Steffl98/autobalanced_photodetector/kicad/Autobalanced_Photodetector/Datasheets/STO46S-Documents/STO46S-Step.step

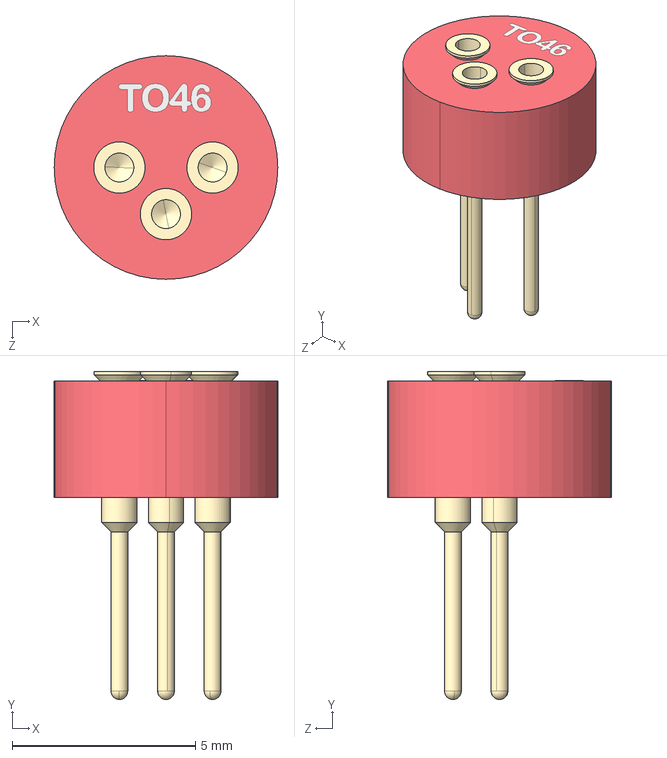
[picture p1: CAD file, 2026-11-10]
kicad/Autobalanced_Photodetector/Datasheets/STO46S-Documents/STO46S-Step.step
6.10 x 8.94 x 6.10 mm
STO46-PC1
2100-9553-0-15-15-21-27-04-0_default x 3
