Steffl98/autobalanced_photodetector/kicad/Autobalanced_Photodetector/Datasheets/STO46S-Documents/STO46S-CAD-DXF.dxf

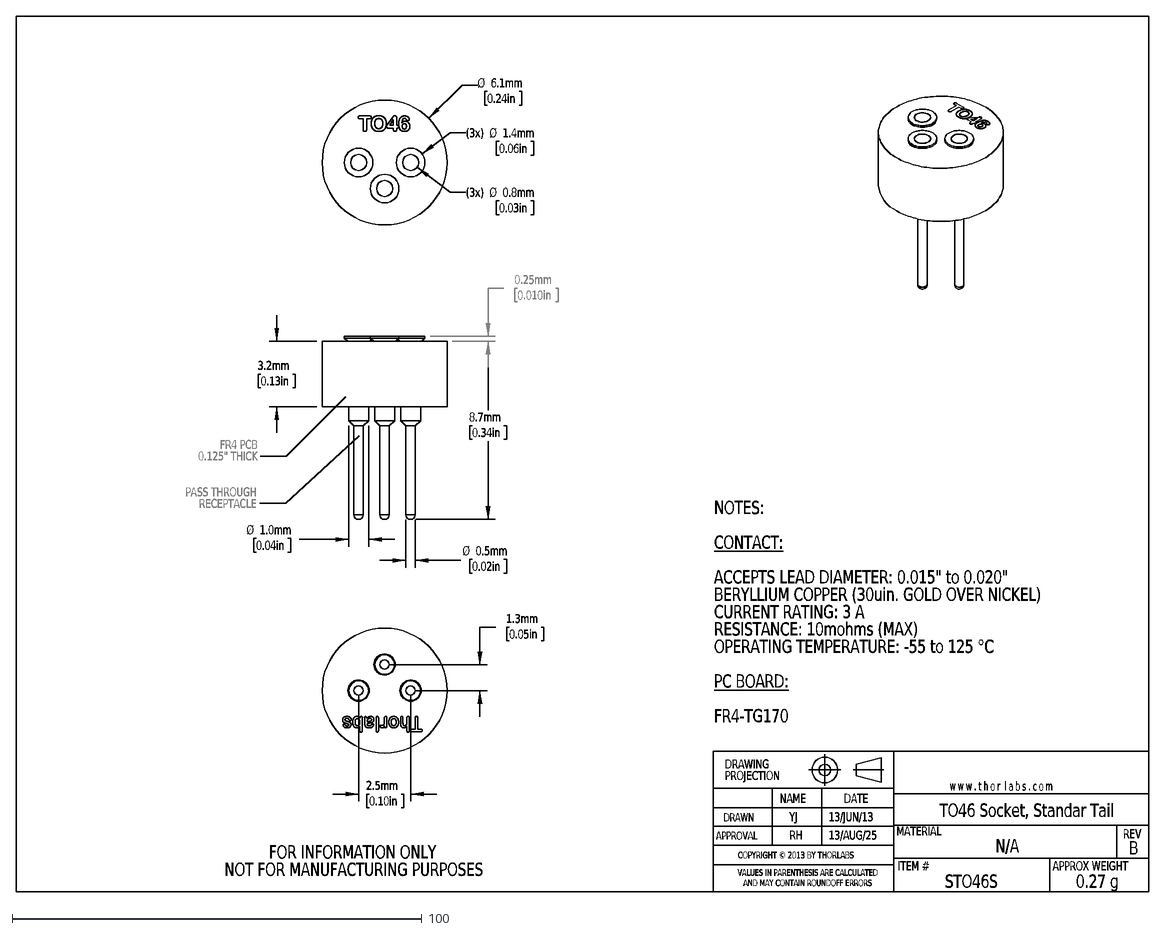
[picture p2: CAD file, 2026-11-10]
kicad/Autobalanced_Photodetector/Datasheets/STO46S-Documents/STO46S-CAD-DXF.dxf
NOTES:
CONTACT:
ACCEPTS LEAD DIAMETER: 0.015" to 0.020"
BERYLLIUM COPPER (30uin. GOLD OVER NICKEL)
CURRENT RATING: 3 A
RESISTANCE: 10mohms (MAX)
OPERATING TEMPERATURE: -55 to 125 °C
PC BOARD:
FR4-TG170
B
STO46S
MATERIAL
DRAWN
APPROVAL
REV
YJ
RH
13/JUN/13
DATE
13/AUG/25
w w w . t h o r l a b s . c o m
ITEM #
APPROX WEIGHT
N/A
0.27 g
VALUES IN PARENTHESIS ARE CALCULATED
AND MAY CONTAIN ROUNDOFF ERRORS
DRAWING
PROJECTION
NAME
FOR INFORMATION ONLY
NOT FOR MANUFACTURING PURPOSES
TO46 Socket, Standar Tail
COPYRIGHT © 2013 BY THORLABS
3.2mm
0.13in
Ø
1.0mm
0.04in
0.5mm
0.02in
8.7mm
0.34in
0.25mm
0.010in
PASS THROUGH
RECEPTACLE
FR4 PCB
0.125" THICK
6.1mm
0.24in
(3x)
1.4mm
0.06in
0.8mm
0.03in
1.3mm
0.05in
2.5mm
0.10in
