Steffl98/autobalanced_photodetector/(list of files, cad)

Other CAD files:
kicad/Autobalanced_Photodetector/Datasheets/STO46S-Documents/STO46S-Solidworks.sldprt
