Steffl98/autobalanced_photodetector/kicad/Autobalanced_Photodetector/Autobalanced_Photodetector.kicad_pcb

## KiCad design kicad/Autobalanced_Photodetector/Autobalanced_Photodetector.kicad_pcb (2026-11-10)

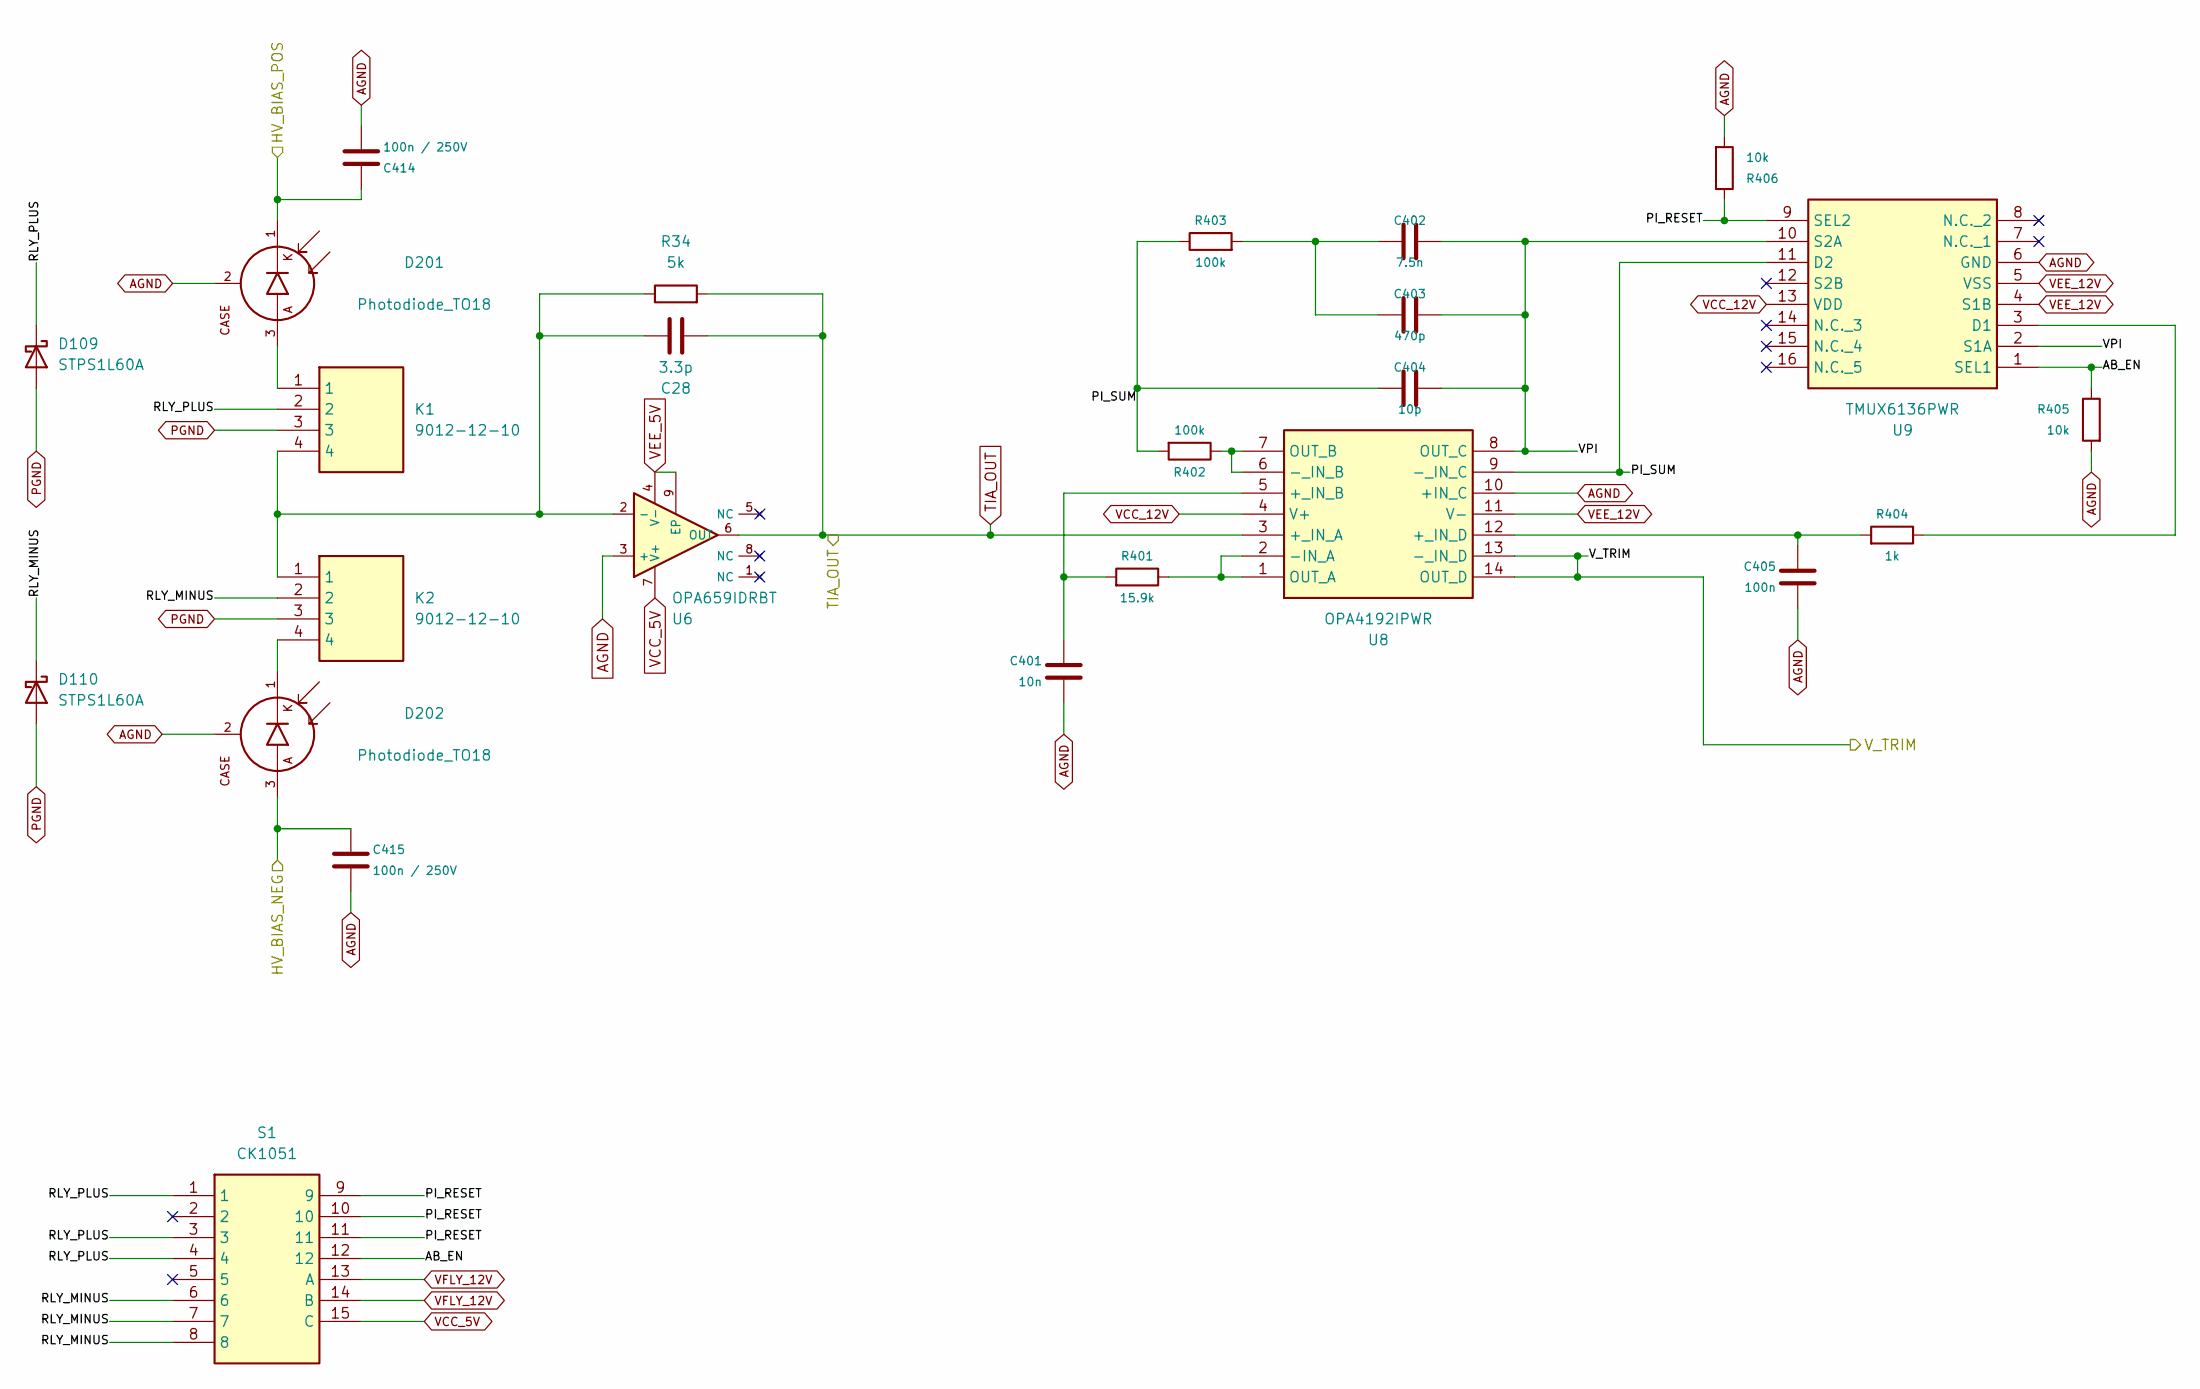
[picture p3: schematic Photodetector.kicad_sch]

Parts:
C28: 3.3p
C401: 10n; C_0603_1608Metric
C402: 7.5n; C_0603_1608Metric
C403: 470p; C_0603_1608Metric
C404: 10p; C_0603_1608Metric
C405: 100n; C_0603_1608Metric
C414, C415: 100n / 250V
D109, D110: STPS1L60A; D_SMA; MPN STPS1L60A
D201, D202: Photodiode_TO18; TO-18-3_Window
K1, K2: 9012-12-10; 90121210; Mouser Part Number 816-9012-12-10
R34: 5k
R401: 15.9k; R_0603_1608Metric
R402, R403: 100k; R_0603_1608Metric
R404: 1k; R_0603_1608Metric
R405, R406: 10k; R_0603_1608Metric
S1: CK1051; Manufacturer_Part_Number CK1051; Mouser Part Number 105-CK1051
U6: OPA659IDRBT; OPA659_DRB; MPN OPA659IDRBT; Mouser Part Number 595-OPA659IDRBT
U8: OPA4192IPWR; SOP65P640X120-14N; Manufacturer_Part_Number OPA4192IPWR; Mouser Part Number 595-OPA4192IPWR
U9: TMUX6136PWR; SOP65P640X120-16N; Manufacturer_Part_Number TMUX6136PWR; Mouser Part Number 595-TMUX6136PWR

Connections:
/HV_Regulator_Neg/HV_BIAS_NEG: C415.1, D202.3 (A); also elsewhere on the board
/HV_Regulator_Pos/HV_BIAS_POS: C414.1, D201.1 (K); also elsewhere on the board
/Photodetector/AB_EN: R405.1, S1.12, U9.1 (SEL1)
/Photodetector/PI_RESET: R406.1, S1.9, S1.10, S1.11, U9.9 (SEL2)
/Photodetector/PI_SUM: C404.1, R402.2, R403.1, U8.9 (-_IN_C), U9.11 (D2)
/Photodetector/RLY_MINUS: D110.1 (K), K2.2, S1.6, S1.7, S1.8
/Photodetector/RLY_PLUS: D109.1 (K), K1.2, S1.1, S1.3, S1.4
/Photodetector/VPI: C402.2, C403.2, C404.2, U8.8 (OUT_C), U9.2 (S1A), U9.10 (S2A)
/Photodetector/V_TRIM: U8.13 (-_IN_D), U8.14 (OUT_D); also elsewhere on the board
AGND: C401.2, C405.2, C414.2, C415.2, D201.2 (CASE), D202.2 (CASE), R405.2, R406.2, U6.3 (+), U8.10 (+IN_C), U9.6 (GND); also elsewhere on the board
unnamed: C402.1, C403.1, R403.2
unnamed: D201.3 (A), K1.1
unnamed: D202.1 (K), K2.4
unnamed: C28.1, K1.4, K2.1, R34.1, U6.2 (-)
unnamed: C401.1, R401.2, U8.5 (+_IN_B)
unnamed: C405.1, R404.2, U8.12 (+_IN_D)
unnamed: R401.1, U8.1 (OUT_A), U8.2 (-IN_A)
unnamed: R402.1, U8.6 (-_IN_B), U8.7 (OUT_B)
unnamed: R404.1, U9.3 (D1)
PGND: D109.2 (A), D110.2 (A), K1.3, K2.3; also elsewhere on the board
TIA_OUT: C28.2, R34.2, U6.6 (OUT), U8.3 (+_IN_A)
VCC_5V: S1.15 (C), U6.7 (V+); also elsewhere on the board
VCC_12V: U8.4 (V+), U9.13 (VDD); also elsewhere on the board
VEE_5V: U6.4 (V-), U6.9 (EP); also elsewhere on the board
VEE_12V: U8.11 (V-), U9.4 (S1B), U9.5 (VSS); also elsewhere on the board
VFLY_12V: S1.13 (A), S1.14 (B); also elsewhere on the board

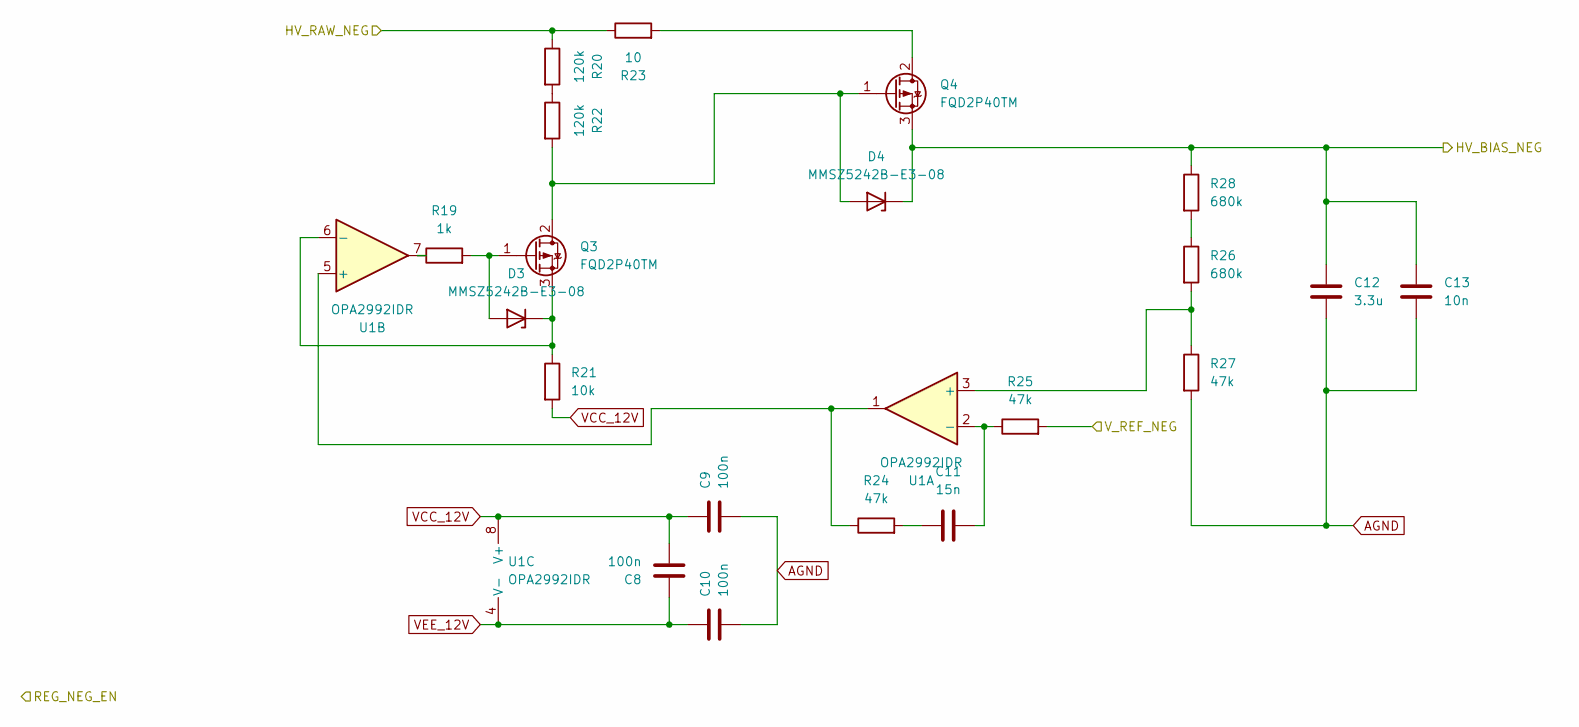
[picture p4: schematic HV_Regulator_Neg.kicad_sch]

Parts:
C8, C9, C10: 100n; C_0805_2012Metric; MPN C0805Y104K1RACTU
C11: 15n; C_0805_2012Metric; MPN C0805X103J5GACTU
C12: 3.3u; C_Rect_L29.0mm_W12.2mm_P27.50mm_MKT; MPN C4AQJBU4330M1WJ
C13: 10n; C_1206_3216Metric; MPN C1206C103JBGACAUTO7210
D3, D4: MMSZ5242B-E3-08; D_SOD-123
Q3, Q4: FQD2P40TM; TO-252-2
R19: 1k; R_0805_2012Metric
R20, R22: 120k; R_1206_3216Metric
R21: 10k; R_0805_2012Metric
R23: 10; R_0805_2012Metric
R24, R25, R27: 47k; R_0805_2012Metric
R26, R28: 680k; R_1206_3216Metric
U1: OPA2992IDR; SOIC-8_3.9x4.9mm_P1.27mm

Connections:
/Flyback/HV_RAW_NEG: R20.1, R23.1; also elsewhere on the board
/HV_Regulator_Neg/HV_BIAS_NEG: C12.1, C13.1, D4.1 (K), Q4.3 (S), R28.1; also elsewhere on the board
/HV_Regulator_Neg/V_REF_NEG: R25.2; also elsewhere on the board
AGND: C9.2, C10.2, C12.2, C13.2, R27.2; also elsewhere on the board
unnamed: C11.1, R24.2
unnamed: D3.2 (A), Q3.1 (G), R19.2
unnamed: D3.1 (K), Q3.3 (S), R21.1, U1.6 (-)
unnamed: D4.2 (A), Q3.2 (D), Q4.1 (G), R22.2
unnamed: Q4.2 (D), R23.2
unnamed: R19.1, U1.7
unnamed: R20.2, R22.1
unnamed: R26.1, R28.2
unnamed: R26.2, R27.1, U1.3 (+)
unnamed: C11.2, R25.1, U1.2 (-)
unnamed: R24.1, U1.1, U1.5 (+)
VCC_12V: C8.2, C9.1, R21.2, U1.8 (V+); also elsewhere on the board
VEE_12V: C8.1, C10.1, U1.4 (V-); also elsewhere on the board

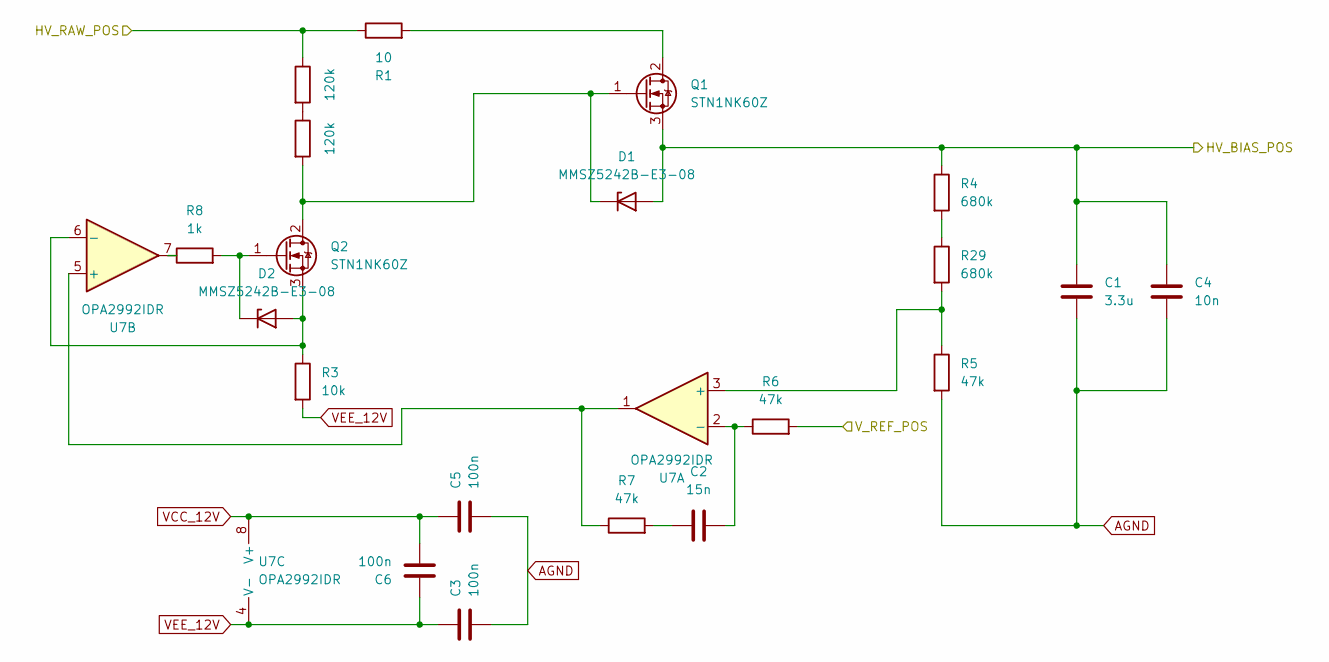
[picture p5: schematic HV_Regulator_Pos.kicad_sch]

Parts:
C1: 3.3u; C_Rect_L29.0mm_W12.2mm_P27.50mm_MKT; MPN C4AQJBU4330M1WJ
C2: 15n; C_0805_2012Metric; MPN C0805X103J5GACTU
C3, C5, C6: 100n; C_0805_2012Metric; MPN C0805Y104K1RACTU
C4: 10n; C_1206_3216Metric; MPN C1206C103JBGACAUTO7210
D1, D2: MMSZ5242B-E3-08; D_SOD-123
Q1, Q2: STN1NK60Z; SOT-223
R1: 10; R_0805_2012Metric
R2, R9: 120k; R_1206_3216Metric
R3: 10k; R_0805_2012Metric
R4, R29: 680k; R_1206_3216Metric
R5, R6, R7: 47k; R_0805_2012Metric
R8: 1k; R_0805_2012Metric
U7: OPA2992IDR; SOIC-8_3.9x4.9mm_P1.27mm

Connections:
/Flyback/HV_RAW_POS: R1.1, R9.1; also elsewhere on the board
/HV_Regulator_Pos/HV_BIAS_POS: C1.1, C4.1, D1.2 (A), Q1.3 (S), R4.1; also elsewhere on the board
/HV_Regulator_Pos/V_REF_POS: R6.2; also elsewhere on the board
AGND: C1.2, C3.2, C4.2, C5.2, R5.2; also elsewhere on the board
unnamed: C2.1, R7.2
unnamed: D1.1 (K), Q1.1 (G), Q2.2 (D), R2.2
unnamed: D2.2 (A), Q2.3 (S), R3.1, U7.6 (-)
unnamed: D2.1 (K), Q2.1 (G), R8.2
unnamed: Q1.2 (D), R1.2
unnamed: R2.1, R9.2
unnamed: R8.1, U7.7
unnamed: R4.2, R29.1
unnamed: R5.1, R29.2, U7.3 (+)
unnamed: C2.2, R6.1, U7.2 (-)
unnamed: R7.1, U7.1, U7.5 (+)
VCC_12V: C5.1, C6.2, U7.8 (V+); also elsewhere on the board
VEE_12V: C3.1, C6.1, R3.2, U7.4 (V-); also elsewhere on the board

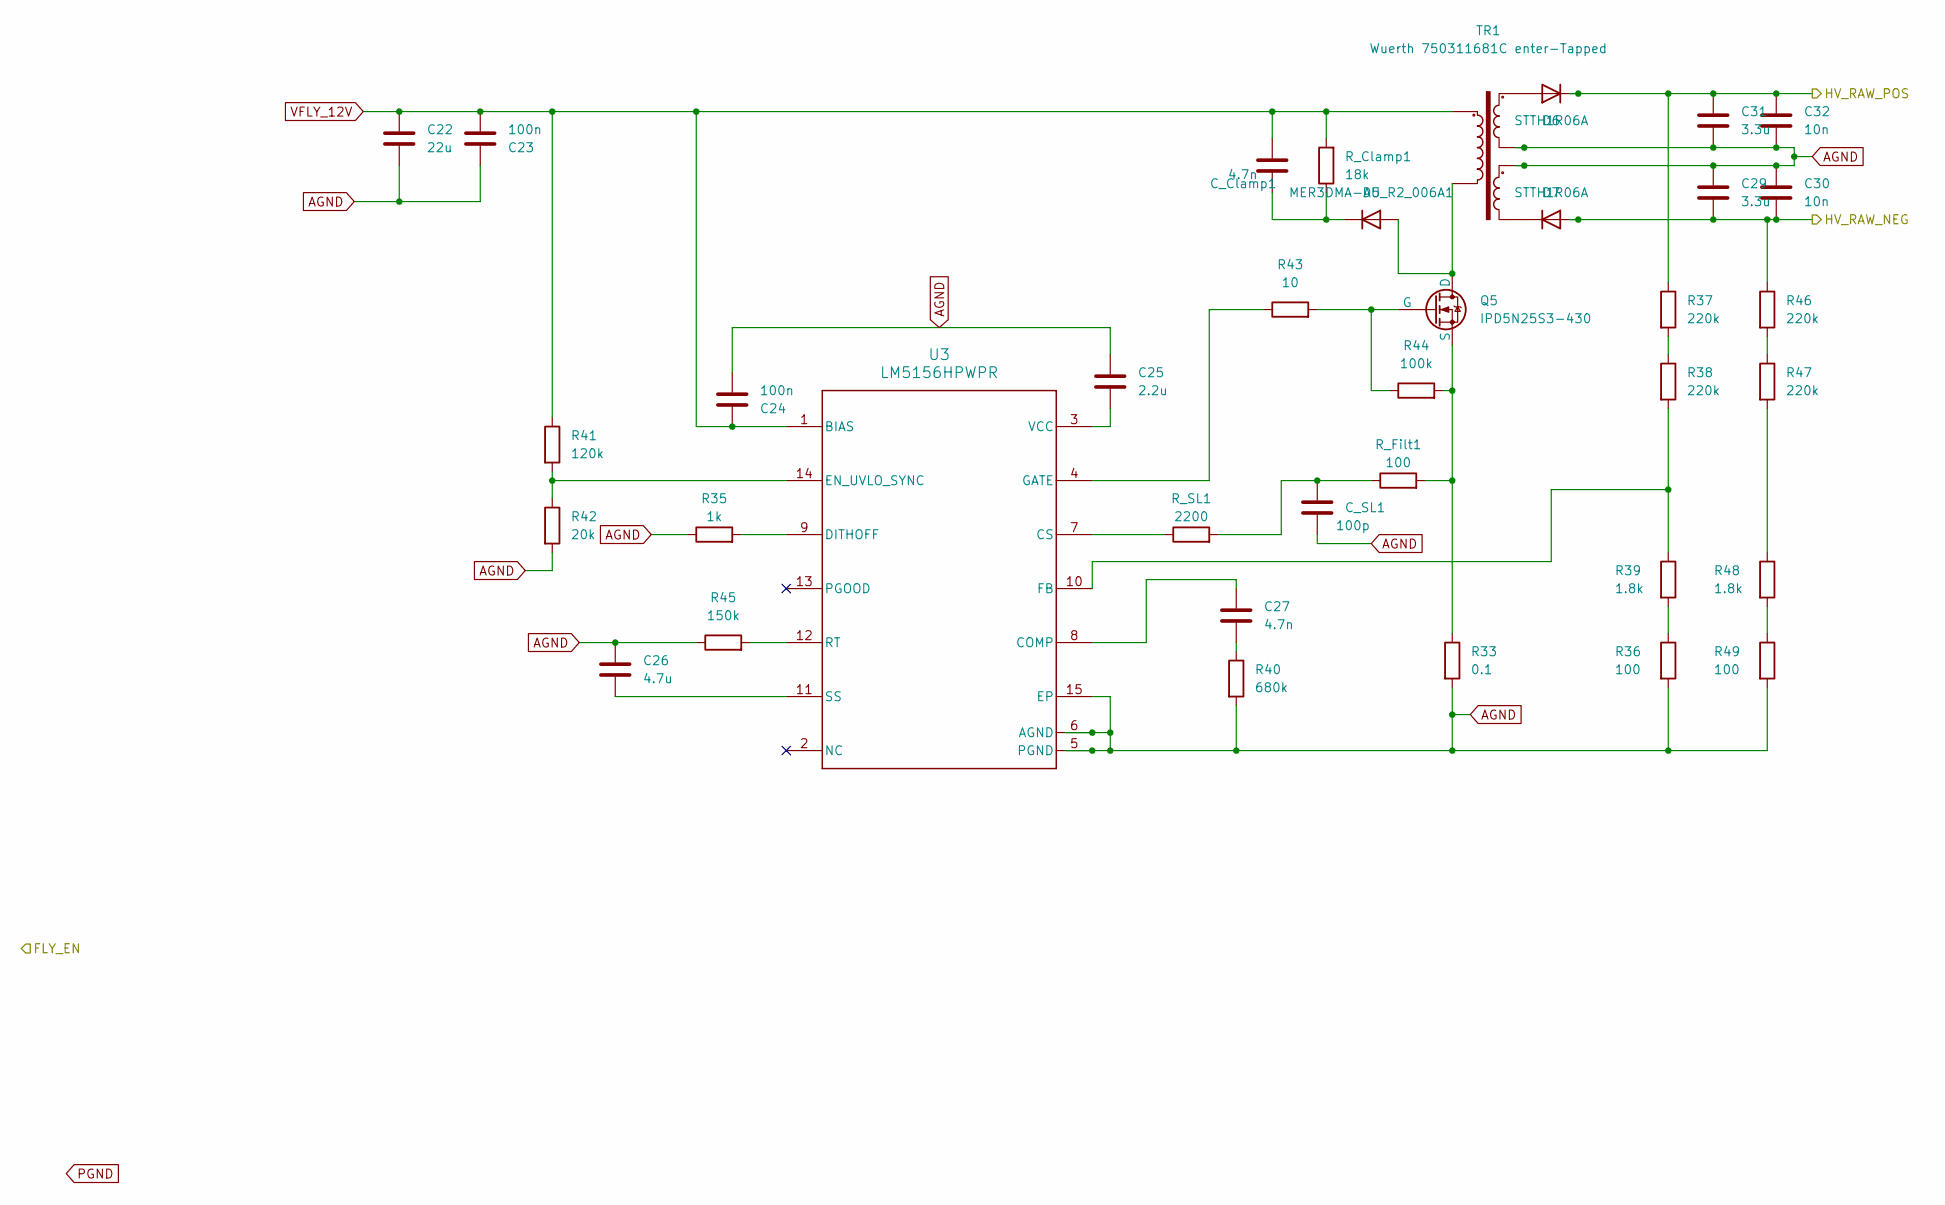
[picture p6: schematic Flyback.kicad_sch]

Parts:
C22: 22u; C_1210_3225Metric; MPN C3225X7R1E226M250AB
C23, C24: 100n; C_0805_2012Metric; MPN C0805Y104K1RACTU
C25: 2.2u; C_0805_2012Metric; MPN GRM21BR71C225KA12L
C26: 4.7u; C_0805_2012Metric; MPN CL21A475KAQNNNG
C27: 4.7n; C_0805_2012Metric; MPN GRM2165C1H472JA01D
C29, C31: 3.3u; C_Rect_L29.0mm_W12.2mm_P27.50mm_MKT; MPN C4AQJBU4330M1WJ
C30, C32: 10n; C_1206_3216Metric; MPN C1206C103JBGACAUTO7210
C_Clamp1: 4.7n; C_1206_3216Metric; MPN C1206C472JBGACTU
C_SL1: 100p; C_0805_2012Metric; MPN C0G
D5: MER3DMA-AU_R2_006A1; D_SMA
D6, D7: STTH1R06A; D_SMA
Q5: IPD5N25S3-430; TO-252-2
R33: 0.1; R_0805_2012Metric
R35: 1k; R_0805_2012Metric
R36, R49: 100; R_0805_2012Metric
R37, R38, R46, R47: 220k; R_1206_3216Metric
R39, R48: 1.8k; R_0805_2012Metric
R40: 680k; R_0805_2012Metric
R41: 120k; R_0805_2012Metric
R42: 20k; R_0805_2012Metric
R43: 10; R_0805_2012Metric
R44: 100k; R_0805_2012Metric
R45: 150k; R_0805_2012Metric
R_Clamp1: 18k; R_0805_2012Metric
R_Filt1: 100; R_0805_2012Metric
R_SL1: 2200; R_0805_2012Metric
TR1: Wuerth 750311681C enter-Tapped; Transformer_Wuerth_750343373
U3: LM5156HPWPR; PWP0014H-IPC_A

Connections:
/Flyback/HV_RAW_NEG: C29.2, C30.2, D7.2 (A), R46.1; also elsewhere on the board
/Flyback/HV_RAW_POS: C31.1, C32.1, D6.1 (K), R37.1; also elsewhere on the board
AGND: C22.2, C23.1, C24.2, C25.1, C26.1, C29.1, C30.1, C31.2, C32.2, C_SL1.1, R33.2, R35.1, R36.2, R40.2, R42.2, R45.1, R49.2, TR1.5, TR1.7, U3.5 (PGND), U3.6 (AGND), U3.15 (EP); also elsewhere on the board
unnamed: C27.1, R40.1
unnamed: C_SL1.2, R_Filt1.1, R_SL1.2
unnamed: D5.2 (A), Q5.1 (D), TR1.1
unnamed: C_Clamp1.2, D5.1 (K), R_Clamp1.1
unnamed: D6.2 (A), TR1.4
unnamed: D7.1 (K), TR1.6
unnamed: Q5.2 (G), R43.2, R44.1
unnamed: Q5.3 (S), R33.1, R44.2, R_Filt1.2
unnamed: R36.1, R39.2
unnamed: R37.2, R38.1
unnamed: R46.2, R47.1
unnamed: R47.2, R48.1
unnamed: R48.2, R49.1
unnamed: C27.2, U3.8 (COMP)
unnamed: R_SL1.1, U3.7 (CS)
unnamed: R35.2, U3.9 (DITHOFF)
unnamed: R41.2, R42.1, U3.14 (EN_UVLO_SYNC)
unnamed: R38.2, R39.1, U3.10 (FB)
unnamed: R43.1, U3.4 (GATE)
unnamed: R45.2, U3.12 (RT)
unnamed: C26.2, U3.11 (SS)
unnamed: C25.2, U3.3 (VCC)
VFLY_12V: C22.1, C23.2, C24.1, C_Clamp1.1, R41.1, R_Clamp1.2, TR1.3, U3.1 (BIAS); also elsewhere on the board

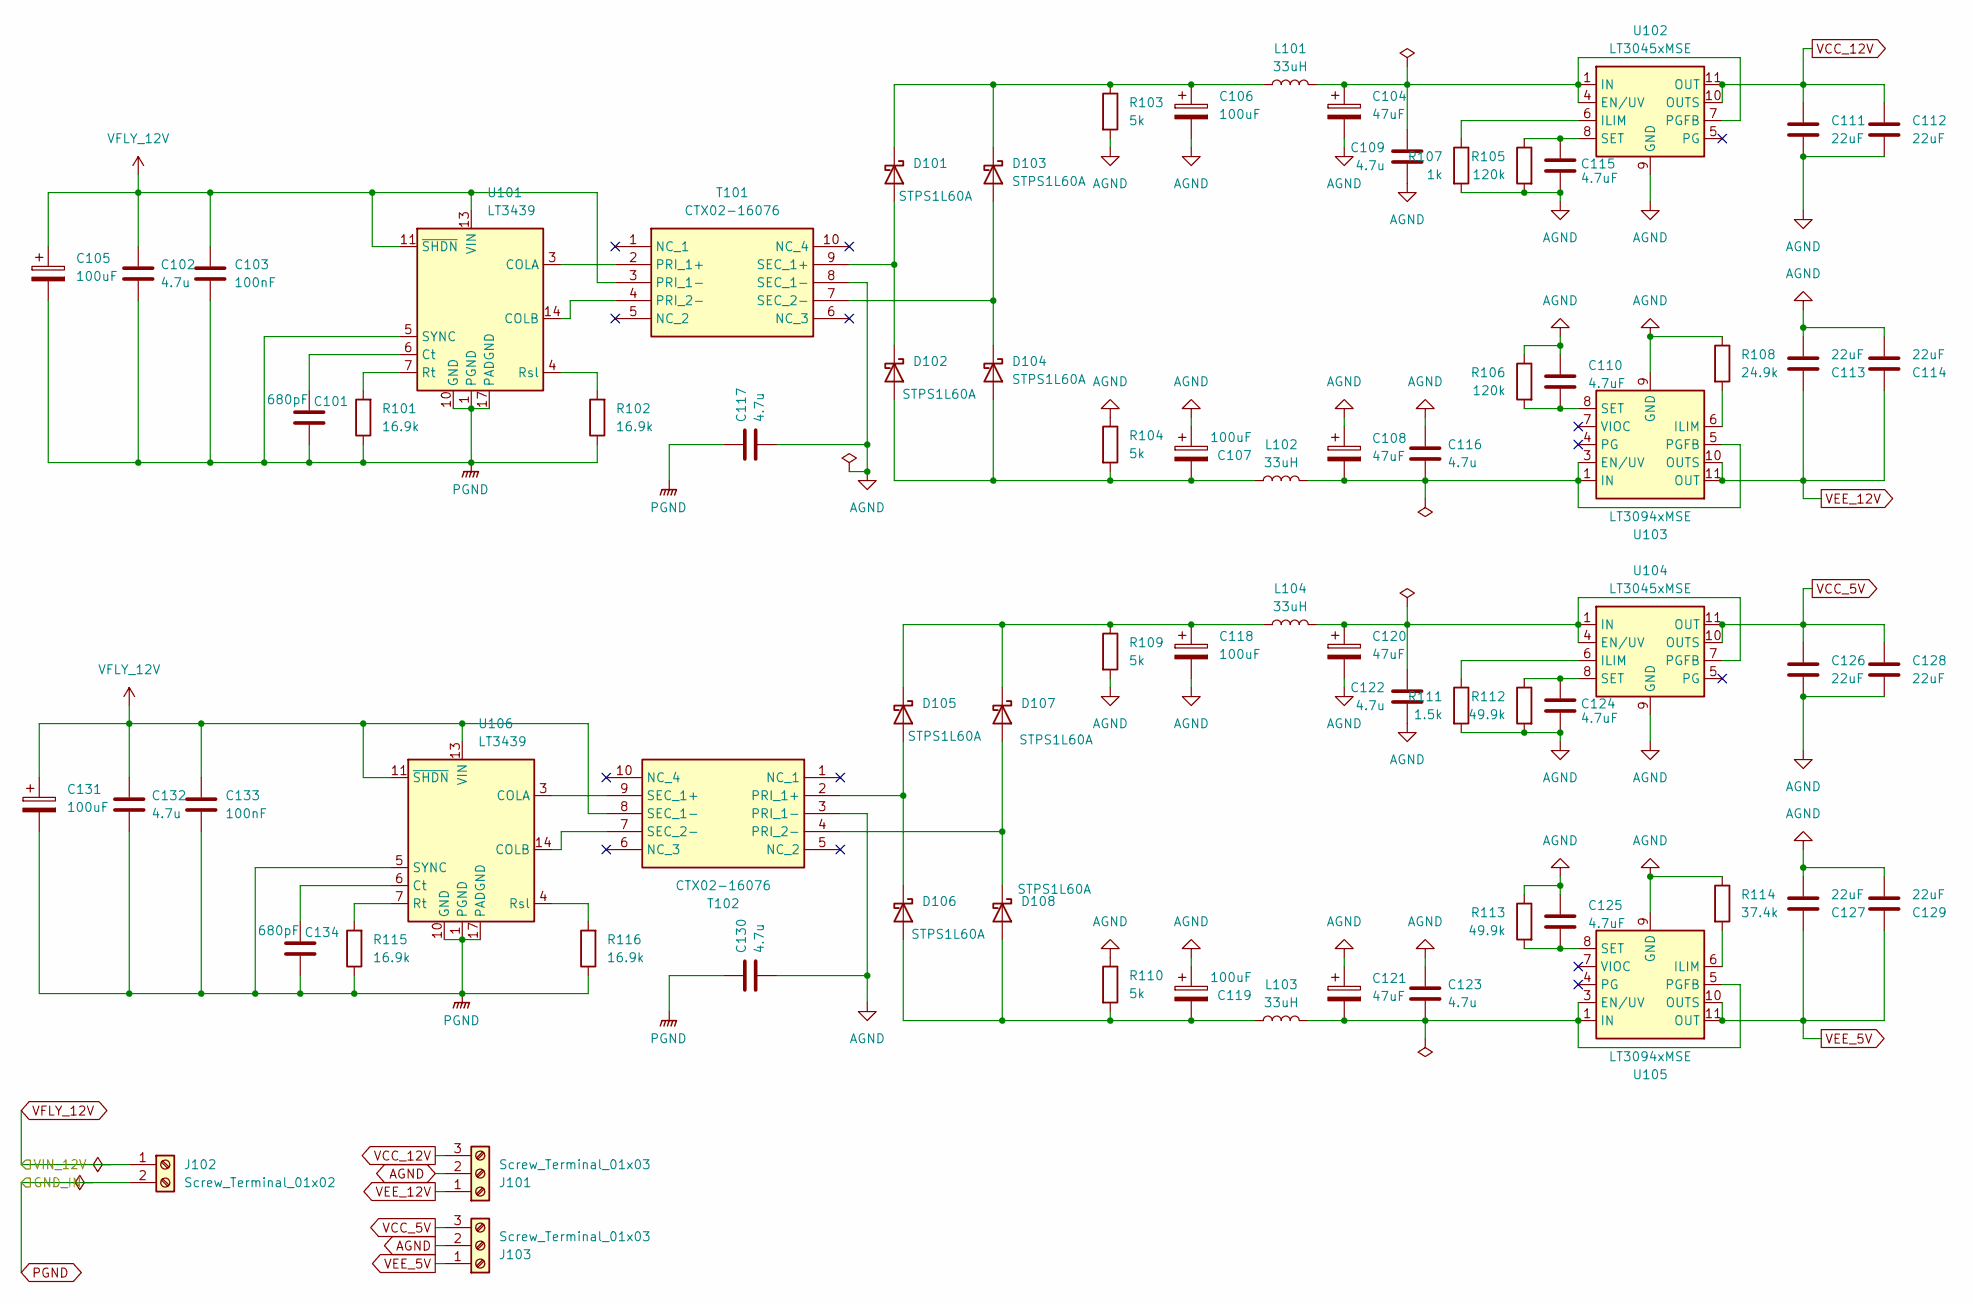
[picture p7: schematic Auxiliary_PSU.kicad_sch, +-12V & +-5V_iso_psu_01R01]

Parts:
C101, C134: 680pF; C_0603_1608Metric; MPN CC0603FRNPO9BN681
C102, C109, C116, C117, C122, C123, C130, C132: 4.7u; C_1206_3216Metric; MPN KGM31AR71E475KU
C103, C133: 100nF; C_0603_1608Metric; MPN CGA3E2X7R1E104M080AA
C104, C108, C120, C121: 47uF; CP_Elec_6.3x5.8; MPN UCL1V470MCL1GS
C105, C106, C107, C118, C119, C131: 100uF; CP_Elec_6.3x7.7; MPN GYE1V101MCQ1GS
C110, C115, C124, C125: 4.7uF; C_0603_1608Metric; MPN C1608X5R1E475K080AC
C111, C112, C113, C114, C126, C127, C128, C129: 22uF; C_1210_3225Metric; MPN MAAST32MSB7226MPNA01
D101, D102, D103, D104, D105, D106, D107, D108: STPS1L60A; D_SMA; MPN STPS1L60A
J101, J103: Screw_Terminal_01x03; TerminalBlock_Phoenix_MKDS-1,5-3-5.08_1x03_P5.08mm_Horizont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; MPN 1715734
J102: Screw_Terminal_01x02; TerminalBlock_Phoenix_MKDS-1,5-2-5.08_1x02_P5.08mm_Horizont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; MPN 1715721
L101, L102, L103, L104: 33uH; L_TDK_VLS5030EX
R101, R102, R115, R116: 16.9k; R_0603_1608Metric; MPN CPF0603F16K9C1
R103, R104, R109, R110: 5k; R_1206_3216Metric; MPN RT0603BRE075KL
R105, R106: 120k; R_0603_1608Metric; MPN RT0603BRD07120KL
R107: 1k; R_0603_1608Metric; MPN RT0603BRD071KL
R108: 24.9k; R_0603_1608Metric; MPN RT0603BRD0724K9L
R111: 1.5k; R_0603_1608Metric; MPN RT0603BRD071K5L
R112, R113: 49.9k; R_0603_1608Metric; MPN RT0603BRD0749K9L
R114: 37.4k; R_0603_1608Metric; MPN RT0603BRE0737K4L
T101, T102: CTX02-16076; CTX0216076; Mouser Part Number 704-CTX02-16076
U101, U106: LT3439; TSSOP-16-1EP_4.4x5mm_P0.65mm
U102, U104: LT3045xMSE; MSOP-12-1EP_3x4.039mm_P0.65mm_EP1.651x2.845mm
U103, U105: LT3094xMSE; MSOP-12-1EP_3x4.039mm_P0.65mm_EP1.651x2.845mm

Connections:
AGND: C104.2, C106.2, C107.1, C108.1, C109.2, C110.1, C111.2, C112.2, C113.2, C114.2, C115.2, C116.1, C117.2, C118.2, C119.1, C120.2, C121.1, C122.2, C123.1, C124.2, C125.1, C126.2, C127.2, C128.2, C129.2, C130.2, J101.2, J103.2, R103.2, R104.1, R105.2, R106.1, R107.2, R108.1, R109.2, R110.1, R111.2, R112.2, R113.1, R114.1, T101.8 (SEC_1-), T102.3 (PRI_1-), U102.9 (GND), U102.13 (GND), U103.9 (GND), U104.9 (GND), U104.13 (GND), U105.9 (GND); also elsewhere on the board
unnamed: D101.2 (A), D102.1 (K), T101.9 (SEC_1+)
unnamed: C106.1, D101.1 (K), D103.1 (K), L101.1, R103.1
unnamed: C107.2, D102.2 (A), D104.2 (A), L102.1, R104.2
unnamed: D103.2 (A), D104.1 (K), T101.7 (SEC_2-)
unnamed: D105.2 (A), D106.1 (K), T102.2 (PRI_1+)
unnamed: C118.1, D105.1 (K), D107.1 (K), L104.1, R109.1
unnamed: C119.2, D106.2 (A), D108.2 (A), L103.1, R110.2
unnamed: D107.2 (A), D108.1 (K), T102.4 (PRI_2-)
unnamed: T101.2 (PRI_1+), U101.3 (COLA)
unnamed: T101.4 (PRI_2-), U101.14 (COLB)
unnamed: T102.9 (SEC_1+), U106.3 (COLA)
unnamed: T102.7 (SEC_2-), U106.14 (COLB)
unnamed: C101.1, U101.6 (Ct)
unnamed: R102.2, U101.4 (Rsl)
unnamed: R101.2, U101.7 (Rt)
unnamed: C104.1, C109.1, L101.2, U102.1 (IN), U102.2 (IN), U102.3 (IN), U102.4 (EN/UV), U102.7 (PGFB)
unnamed: R107.1, U102.6 (ILIM)
unnamed: C115.1, R105.1, U102.8 (SET)
unnamed: C108.2, C116.2, L102.2, U103.1 (IN), U103.2 (IN), U103.3 (EN/UV), U103.5 (PGFB), U103.13 (IN)
unnamed: R108.2, U103.6 (ILIM)
unnamed: C110.2, R106.2, U103.8 (SET)
unnamed: C120.1, C122.1, L104.2, U104.1 (IN), U104.2 (IN), U104.3 (IN), U104.4 (EN/UV), U104.7 (PGFB)
unnamed: R111.1, U104.6 (ILIM)
unnamed: C124.1, R112.1, U104.8 (SET)
unnamed: C121.2, C123.2, L103.2, U105.1 (IN), U105.2 (IN), U105.3 (EN/UV), U105.5 (PGFB), U105.13 (IN)
unnamed: R114.2, U105.6 (ILIM)
unnamed: C125.2, R113.2, U105.8 (SET)
unnamed: C134.1, U106.6 (Ct)
unnamed: R116.2, U106.4 (Rsl)
unnamed: R115.2, U106.7 (Rt)
PGND: C101.2, C102.2, C103.2, C105.2, C117.1, C130.1, C131.2, C132.2, C133.2, C134.2, J102.2, R101.1, R102.1, R115.1, R116.1, U101.1 (PGND), U101.5 (SYNC), U101.10 (GND), U101.16 (PGND), U101.17 (PADGND), U106.1 (PGND), U106.5 (SYNC), U106.10 (GND), U106.16 (PGND), U106.17 (PADGND); also elsewhere on the board
VCC_5V: C126.1, C128.1, J103.3, U104.10 (OUTS), U104.11 (OUT), U104.12 (OUT); also elsewhere on the board
VCC_12V: C111.1, C112.1, J101.3, U102.10 (OUTS), U102.11 (OUT), U102.12 (OUT); also elsewhere on the board
VEE_5V: C127.1, C129.1, J103.1, U105.10 (OUTS), U105.11 (OUT), U105.12 (OUT); also elsewhere on the board
VEE_12V: C113.1, C114.1, J101.1, U103.10 (OUTS), U103.11 (OUT), U103.12 (OUT); also elsewhere on the board
VFLY_12V: C102.1, C103.1, C105.1, C131.1, C132.1, C133.1, J102.1, T101.3 (PRI_1-), T102.8 (SEC_1-), U101.11 (~SHDN), U101.13 (VIN), U106.11 (~SHDN), U106.13 (VIN); also elsewhere on the board

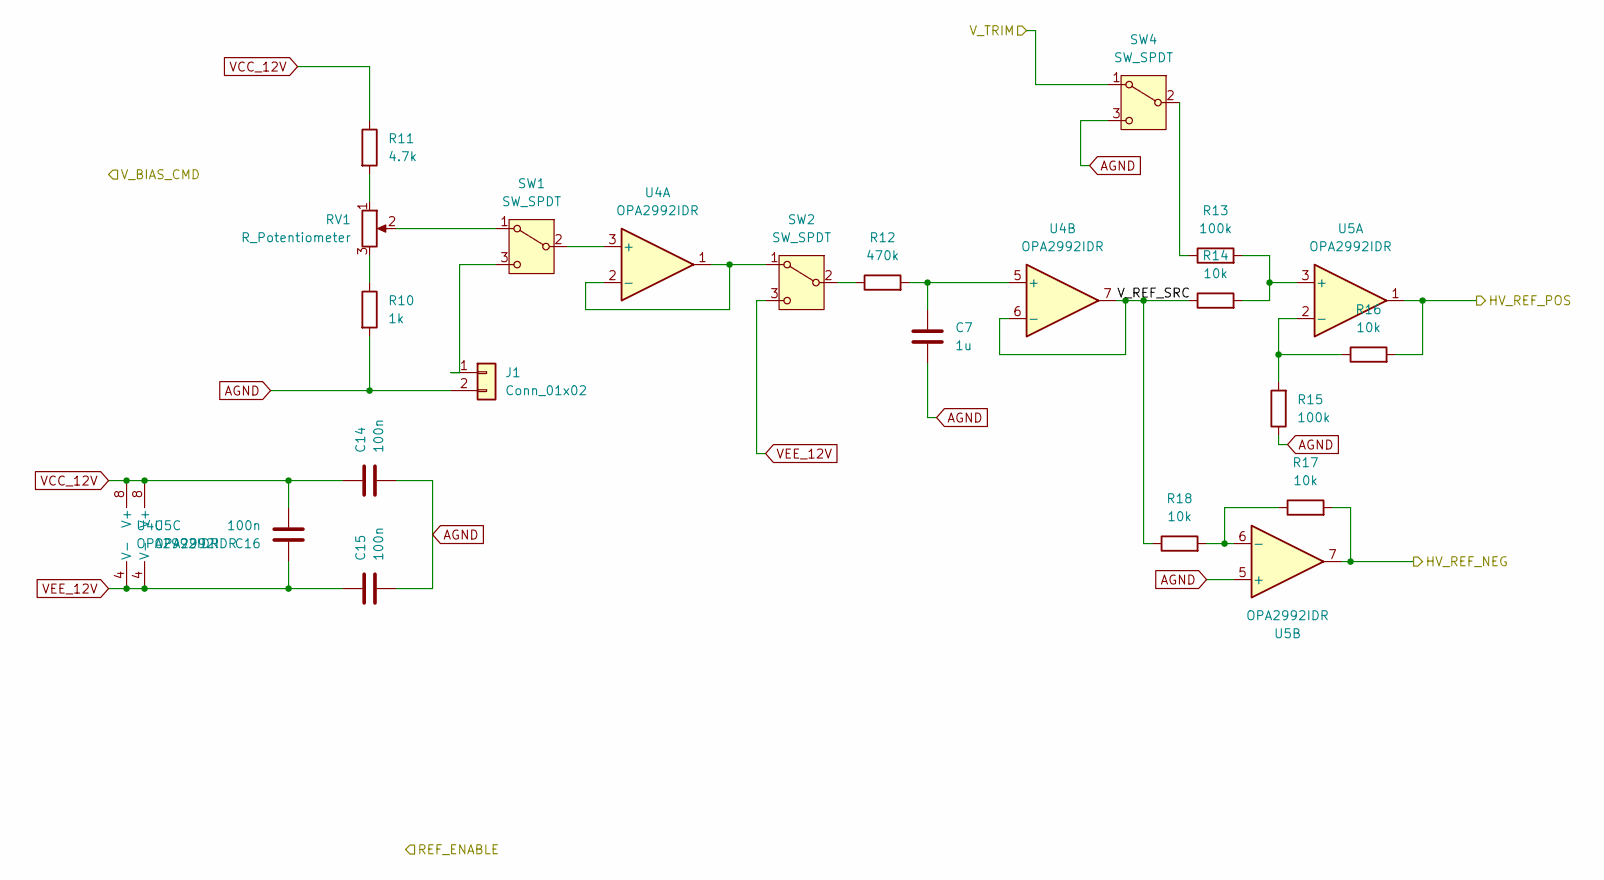
[picture p8: schematic Reference_Control.kicad_sch]

Parts:
C7: 1u; C_Rect_L13.0mm_W4.0mm_P10.00mm_FKS3_FKP3_MKS4; MPN MKS4C041003C00KSSD
C14, C15, C16: 100n; C_0805_2012Metric; MPN C0805Y104K1RACTU
J1: Conn_01x02; TerminalBlock_Phoenix_MKDS-1,5-2-5.08_1x02_P5.08mm_Horizont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; MPN 1715721
R10: 1k; R_0805_2012Metric
R11: 4.7k; R_0805_2012Metric
R12: 470k; R_0805_2012Metric
R13, R15: 100k; R_0805_2012Metric
R14, R16, R17, R18: 10k; R_0805_2012Metric
RV1: R_Potentiometer; Potentiometer_Bourns_PTV09A-1_Single_Vertical
SW1, SW2, SW4: SW_SPDT; SW_Slide_SPDT_Straight_CK_OS102011MS2Q; MPN OS102011MS2QN1
U4, U5: OPA2992IDR; SOIC-8_3.9x4.9mm_P1.27mm

Connections:
/HV_Regulator_Neg/V_REF_NEG: R17.2, U5.7; also elsewhere on the board
/HV_Regulator_Pos/V_REF_POS: R16.2, U5.1; also elsewhere on the board
/Photodetector/V_TRIM: SW4.1 (A); also elsewhere on the board
/Reference_Control/V_REF_SRC: R14.1, R18.1, U4.6 (-), U4.7
AGND: C7.2, C14.2, C15.2, J1.2, R10.2, R15.1, SW4.3 (C), U5.5 (+); also elsewhere on the board
unnamed: J1.1, SW1.3 (C)
unnamed: R10.1, RV1.3
unnamed: R11.2, RV1.1
unnamed: RV1.2, SW1.1 (A)
unnamed: SW1.2 (B), U4.3 (+)
unnamed: SW2.1 (A), U4.1, U4.2 (-)
unnamed: R12.1, SW2.2 (B)
unnamed: R13.1, SW4.2 (B)
unnamed: C7.1, R12.2, U4.5 (+)
unnamed: R13.2, R14.2, U5.3 (+)
unnamed: R15.2, R16.1, U5.2 (-)
unnamed: R17.1, R18.2, U5.6 (-)
VCC_12V: C14.1, C16.2, R11.1, U4.8 (V+), U5.8 (V+); also elsewhere on the board
VEE_12V: C15.1, C16.1, SW2.3 (C), U4.4 (V-), U5.4 (V-); also elsewhere on the board

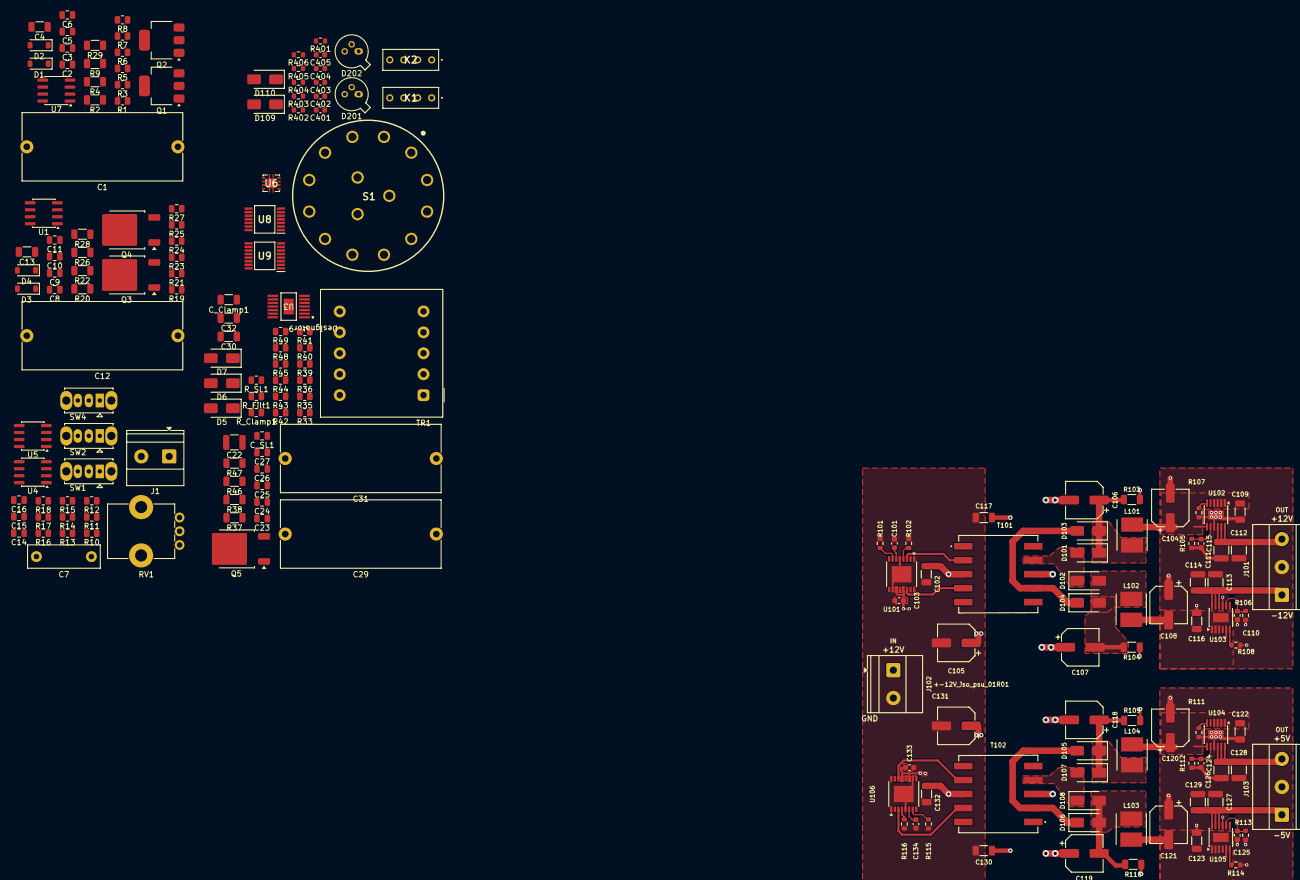
[picture p9: board Autobalanced_Photodetector.kicad_pcb from above]

Board: 2 copper layers, 193 parts (0 on the bottom side), 117 nets.
