Steffl98/autobalanced_photodetector/(commit log)

2026-10-19 Initial KiCad project
    [Autobalanced_Photodetector.kicad_pcb, Autobalanced_Photodetector.kicad_sch]
2026-10-24 Add hierarchical KiCad schematics
    [Autobalanced_Photodetector.kicad_sch, Balance_Controller.kicad_sch, Flyback.kicad_sch, HV_Regulator_Neg.kicad_sch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]
2026-10-29 feat(kicad): add HV regulators and reference control
    [Autobalanced_Photodetector.kicad_sch, Balance_Controller.kicad_sch, Flyback.kicad_sch, HV_Regulator_Neg.kicad_sch, Power_Interfaces.kicad_sch, Protection_Sequencing.kicad_sch, Reference_Control.kicad_sch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]
2026-11-08 Add LM5156H flyback and update schematics
    [Balance_Controller.kicad_sch, Flyback.kicad_sch, HV_Regulator_Neg.kicad_sch, Reference_Control.kicad_sch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]
2026-11-08 Added footprint library
2026-11-08 Completed BoM
    [Flyback.kicad_sch]
2026-11-08 Fixed footprints
    [Flyback.kicad_sch]
2026-11-10 Integration von auxiliary PSU and photodetector schematics
    [Autobalanced_Photodetector.kicad_pcb, Autobalanced_Photodetector.kicad_sch, Auxiliary_PSU.kicad_sch, Balance_Controller.kicad_sch, Flyback.kicad_sch, HV_Regulator_Neg.kicad_sch, Photodetector.kicad_sch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]
